vishishere123/Anand1/Hardware/Bottom/Anand1-BottomNew.brd

## EAGLE design Hardware/Bottom/Anand1-BottomNew.brd (2020-07-09)

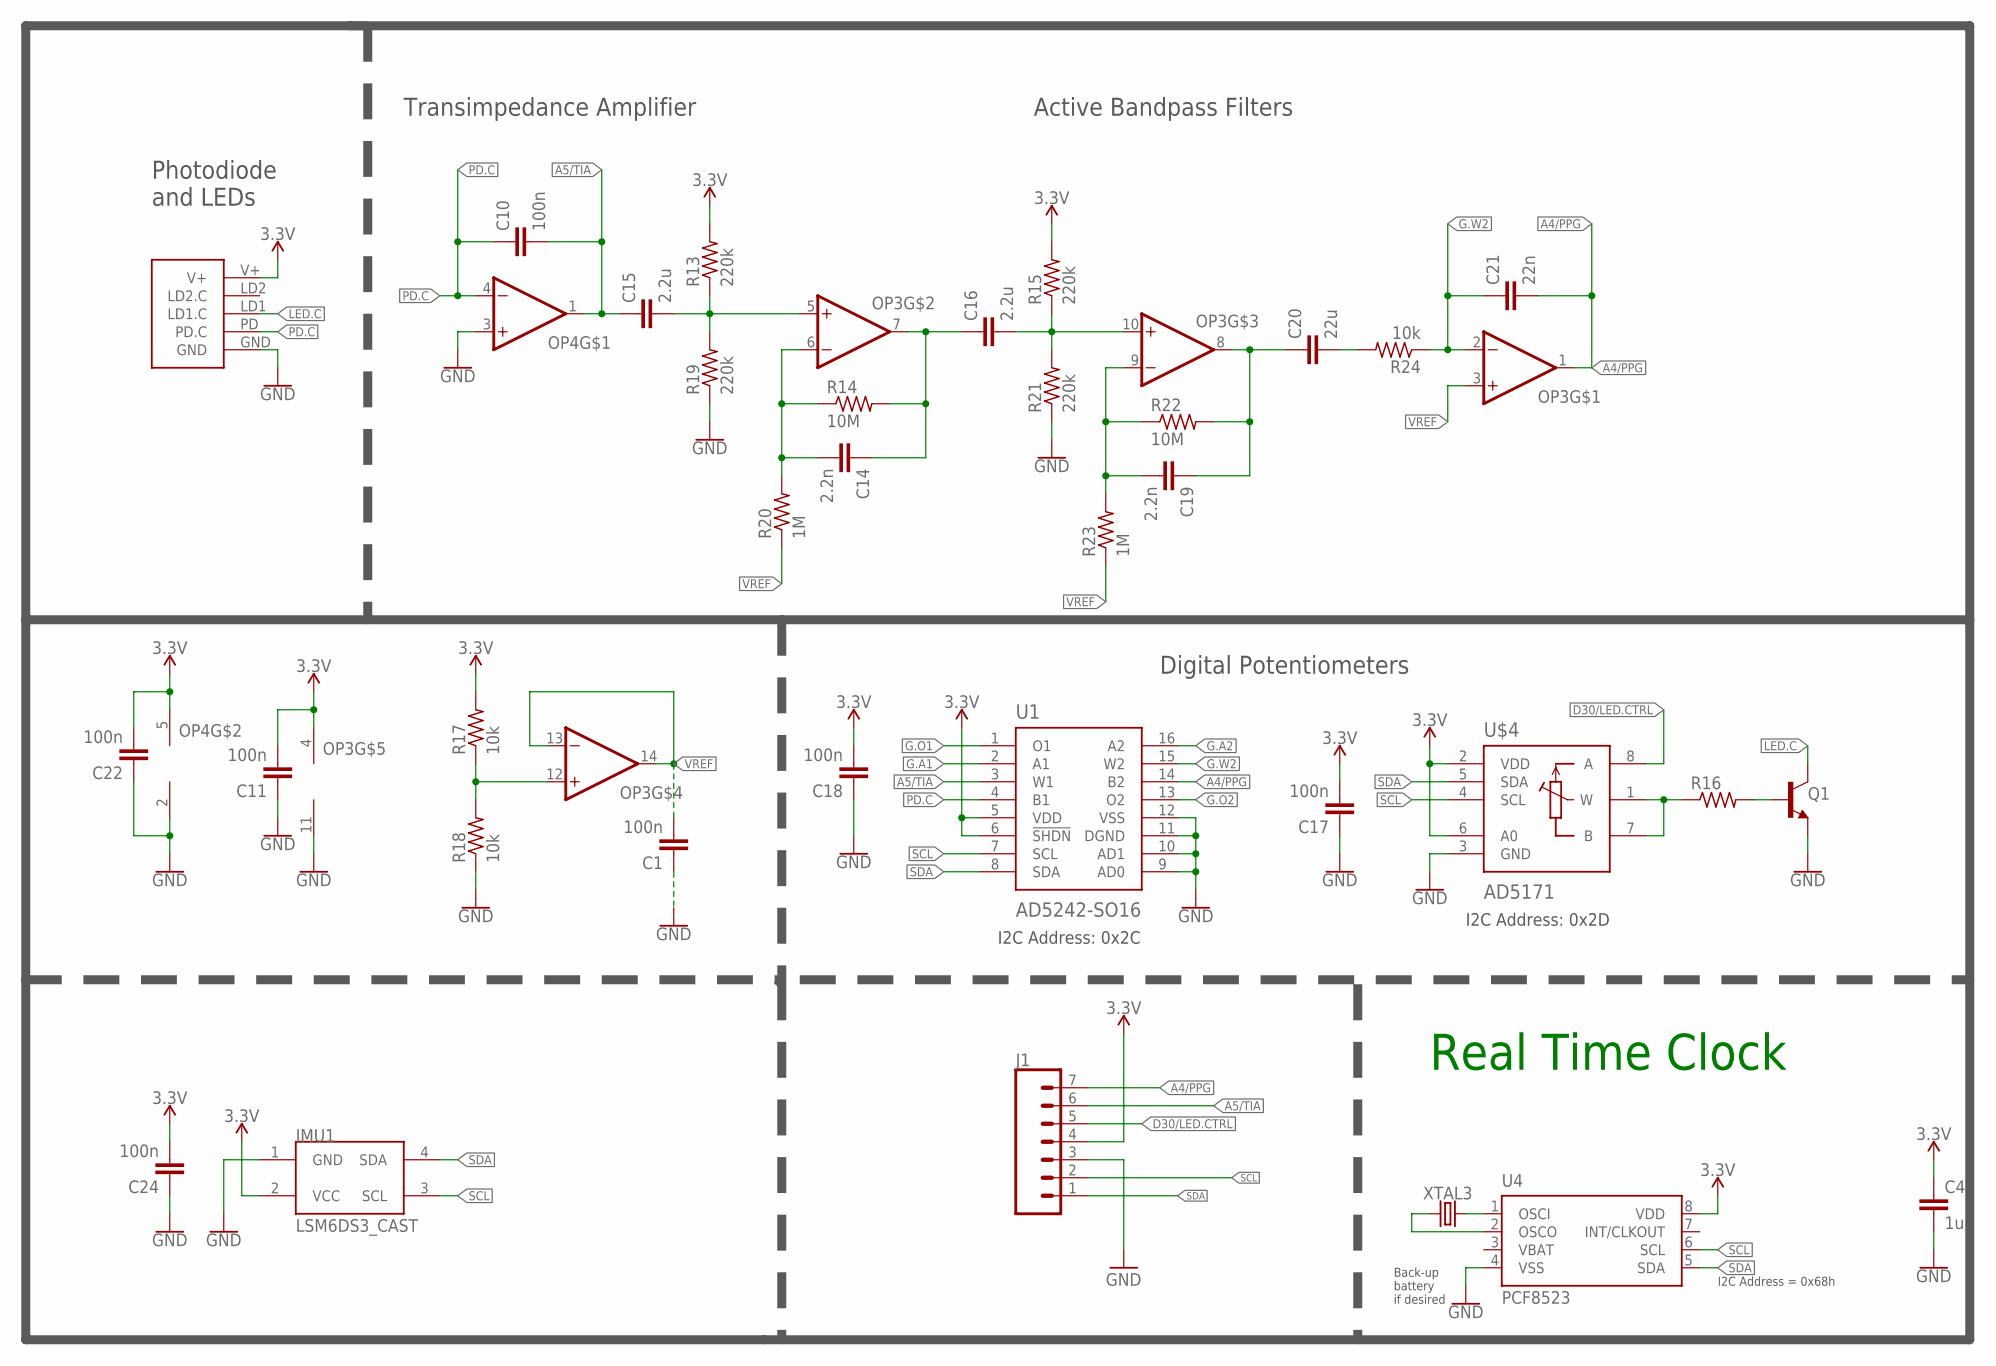
[picture p10: schematic Anand1-BottomNew.sch]

Parts:
C1, C10, C11, C17, C18, C22, C24: 100n; C0603
C4: 1u; C0603
C14, C19: 2.2n; C0603
C15, C16: 2.2u; C0603
C20: 22u; C0603
C21: 22n; C0603
IMU1: LSM6DS3_CAST
J1: CONN_07-1.27MM; 1X07_1.27MM
OP3: OP-QUAD-SO14; SO14
OP4: OP-SINGLEOT; SOT23-5
Q1: NPN-GENERIC; SOT23-3
R13, R15, R19, R21: 220k; R0603
R14, R22: 10M; R0603
R16: RESISTOR0603; R0603
R17, R18: 10k; R0402
R20, R23: 1M; R0603
R24: 10k; R0603
U1: AD5242-SO16; SO16
U4: PCF8523; SO8; DIGIKEY 568-5306-1-ND
U$3: PPG.MODULE.2
U$4: AD5171; SOT-23-8
XTAL3: 32.7680kHz; 2-SMD.NOLEAD.2.0MMTO1.2MM

Connections:
3.3V: C4.1, C11.2, C17.2, C18.2, C22.2, C24.2, IMU1.2 (VCC), J1.4, OP3.4 (V+), OP4.5 (V+), R13.2, R15.2, R17.2, U1.5 (VDD), U1.6 (!SHDN), U4.8 (VDD), U$3.V+, U$4.2 (VDD), U$4.6 (A0)
A4/PPG: C21.2, J1.7, OP3.1 (OUT), U1.14 (B2)
A5/TIA: C10.2, C15.1, J1.6, OP4.1 (OUT), U1.3 (W1)
D30/LED.CTRL: J1.5, U$4.8 (A)
G.A1: U1.2 (A1)
G.A2: U1.16 (A2)
G.O1: U1.1 (O1)
G.O2: U1.13 (O2)
G.W2: C21.1, OP3.2 (-IN), R24.1, U1.15 (W2)
GND: C1.1, C4.2, C11.1, C17.1, C18.1, C22.1, C24.1, IMU1.1 (GND), J1.3, OP3.11 (V-), OP4.2 (V-), OP4.3 (+IN), Q1.2 (E), R18.1, R19.1, R21.1, U1.9 (AD0), U1.10 (AD1), U1.11 (DGND), U1.12 (VSS), U4.4 (VSS), U$3.GND, U$4.3 (GND)
LED.C: Q1.3 (C), U$3.LD1 (LD1.C)
unnamed: U4.2 (OSCO), XTAL3.P$1 (1)
unnamed: U4.1 (OSCI), XTAL3.P$2 (2)
unnamed: Q1.1 (B), R16.2
unnamed: R16.1, U$4.1 (W), U$4.7 (B)
unnamed: OP3.12 (+IN), R17.1, R18.2
unnamed: C15.2, OP3.5 (+IN), R13.1, R19.2
unnamed: C14.2, OP3.6 (-IN), R14.1, R20.2
unnamed: C14.1, C16.1, OP3.7 (OUT), R14.2
unnamed: C16.2, OP3.10 (+IN), R15.1, R21.2
unnamed: C19.2, OP3.9 (-IN), R22.1, R23.2
unnamed: C19.1, C20.1, OP3.8 (OUT), R22.2
unnamed: C20.2, R24.2
PD.C: C10.1, OP4.4 (-IN), U1.4 (B1), U$3.PD (PD.C)
SCL: IMU1.3 (SCL), J1.2, U1.7 (SCL), U4.6 (SCL), U$4.4 (SCL)
SDA: IMU1.4 (SDA), J1.1, U1.8 (SDA), U4.5 (SDA), U$4.5 (SDA)
VBAT: U4.3 (VBAT)
VREF: C1.2, OP3.3 (+IN), OP3.13 (-IN), OP3.14 (OUT), R20.1, R23.1

Notes on the sheet:
Photodiode and LEDs
Active Bandpass Filters
Digital Potentiometers
Transimpedance Amplifier
I2C Address: 0x2C
I2C Address: 0x2D
I2C Address = 0x68h
Back-up battery if desired
Real Time Clock

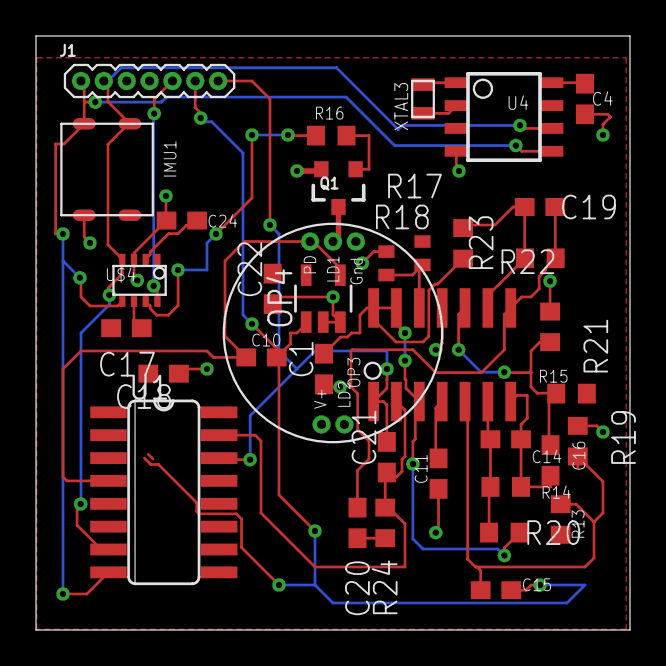
[picture p11: board Anand1-BottomNew.brd from above]

Board: 2 copper layers, 33.0 x 33.0 mm, 36 parts (0 on the bottom side), 23 nets.
