vishishere123/Anand1/(commit log)

2020-06-04 Eagle Files for Top module
    [Anand1-TOP.brd, Anand1-TOP.sch]
2020-06-04 Eagle Files for Bottom Module
    [Anand1-Bottom.brd, Anand1-Bottom.sch]
2020-06-04 EAGLE Files for PPG Module
    [Anand1-PPG-Module.brd, Anand1-PPG-Module.sch]
2020-06-04 Arduino File for Software
2020-06-04 Top board not routed yet
    [Anand1-TOP.brd, Anand1-TOP.sch]
2020-07-09 added new top and bottom board and schematic files
    [Anand1-BottomNew.brd, Anand1-BottomNew.sch, Anand1-TOP_New.brd, Anand1-TOP_New.sch]
2020-11-22 added PPG Module board, BOM, and gitignore
    [Anand1-PPG-Module-BOM.xlsx, Anand1-PPG-Module.brd, Anand1-PPG-Module.sch]
